pj66666/Wireless-motion-sensor-node/picture/IMG20201013174246.jpg.JPG

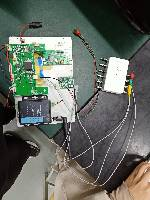
picture/IMG20201013174246.jpg.JPG
