pj66666/Wireless-motion-sensor-node/picture/IMG20201013153739.jpg.JPG

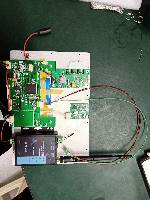
picture/IMG20201013153739.jpg.JPG
