pj66666/Wireless-motion-sensor-node/README.md

Here are the corresponding result images and documents. The code will not be uploaded for the time being.
## Finished product:


## Visual interface:
