pj66666/Wireless-motion-sensor-node/picture/IMG20201012195645.jpg

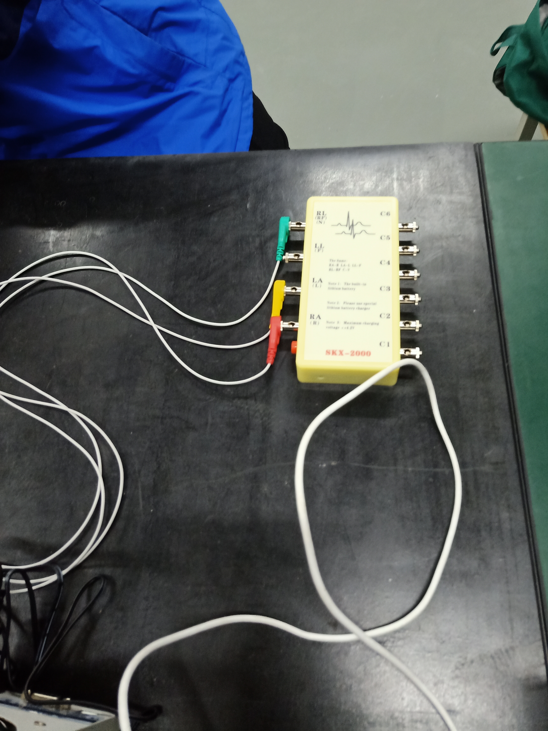
picture/IMG20201012195645.jpg
