pj66666/Wireless-motion-sensor-node/picture/IMG20201012200358.jpg.JPG

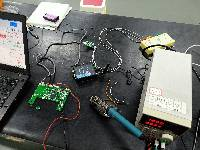
picture/IMG20201012200358.jpg.JPG
