pj66666/Wireless-motion-sensor-node/picture/IMG20201013011721.jpg.JPG

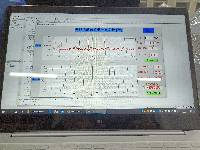
picture/IMG20201013011721.jpg.JPG
