pj66666/Wireless-motion-sensor-node/picture/IMG20201013015030.jpg

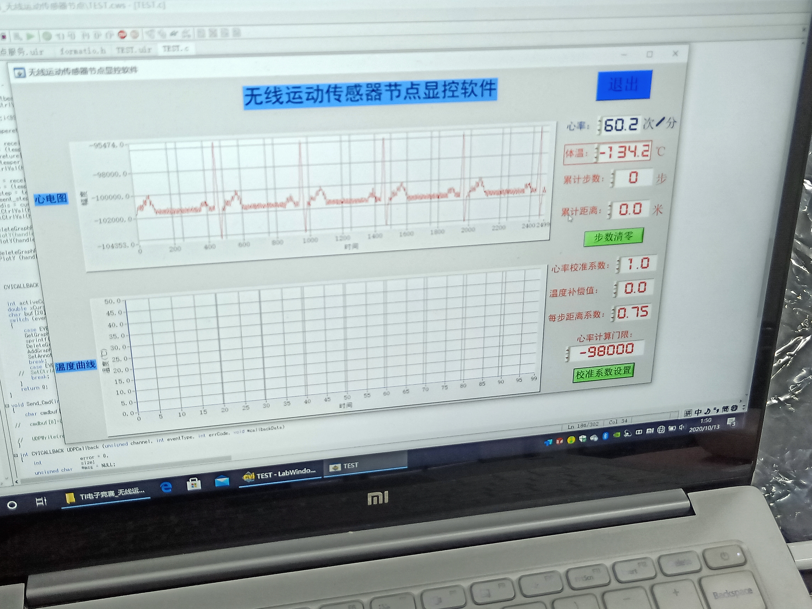
picture/IMG20201013015030.jpg
