pj66666/Wireless-motion-sensor-node/picture/IMG20201013153730.jpg.JPG

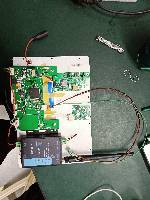
picture/IMG20201013153730.jpg.JPG
