pj66666/Wireless-motion-sensor-node/picture/IMG20201013160143.jpg

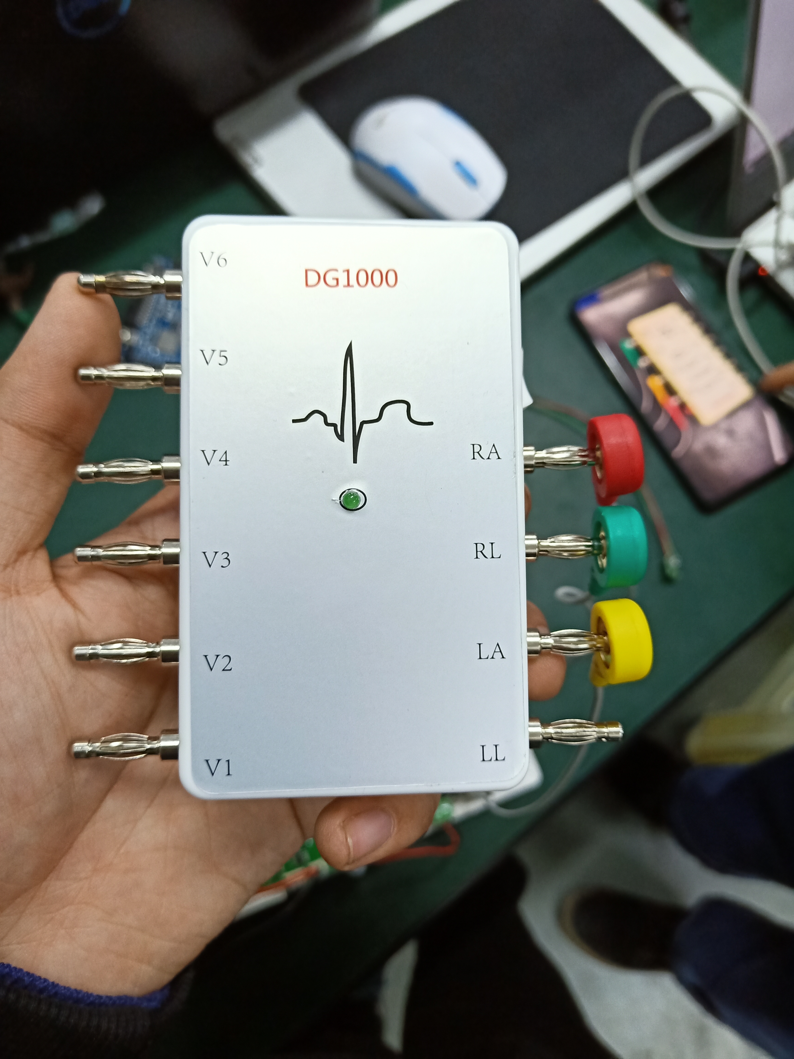
picture/IMG20201013160143.jpg
