pj66666/Wireless-motion-sensor-node/picture/IMG20201013165434.jpg.JPG

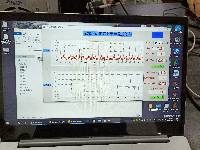
picture/IMG20201013165434.jpg.JPG
