pj66666/Wireless-motion-sensor-node/picture/IMG_20201013_153217.jpg

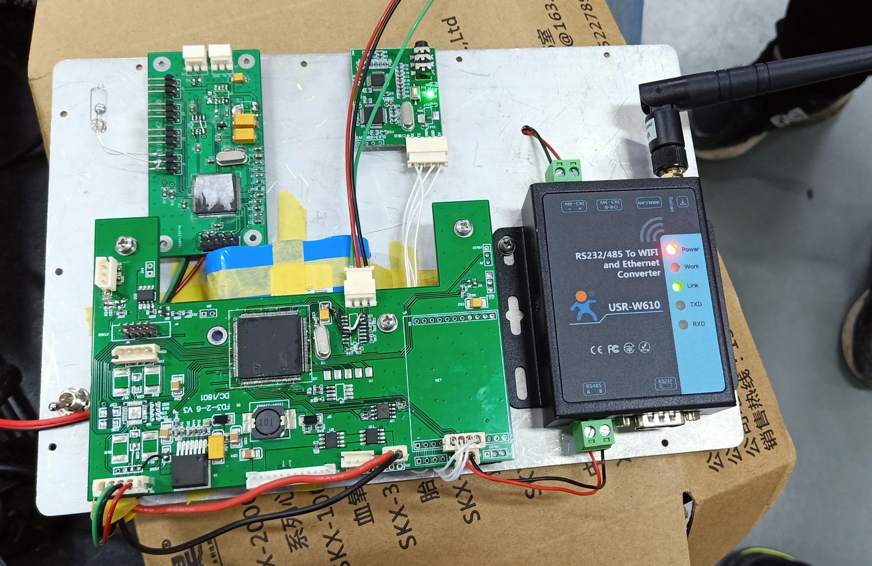
picture/IMG_20201013_153217.jpg
