pj66666/Wireless-motion-sensor-node/picture/IMG_20201013_153750.jpg.JPG

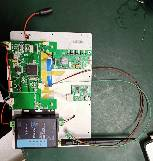
picture/IMG_20201013_153750.jpg.JPG
